jbilander/A500_IDE_LED_board/A500_IDE_LED_board_schematic.pdf

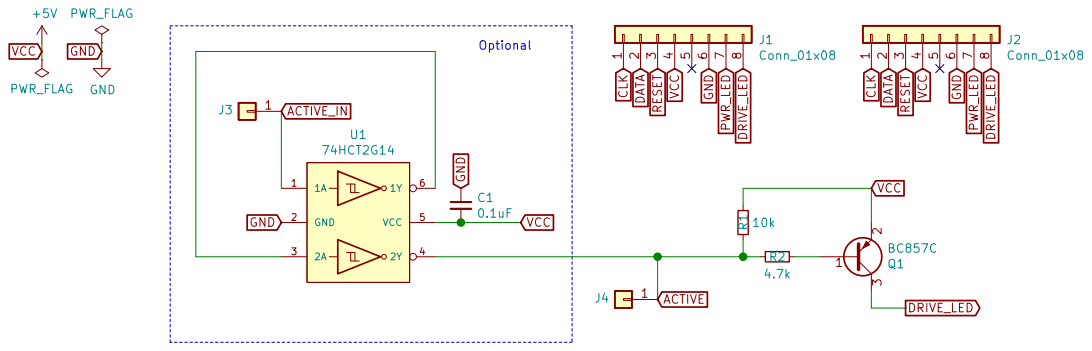
[picture p13: page 1]
