jbilander/A500_IDE_LED_board/KiCad/A500_IDE_LED_board.kicad_pcb

## KiCad design KiCad/A500_IDE_LED_board.kicad_pcb (2022-03-10)

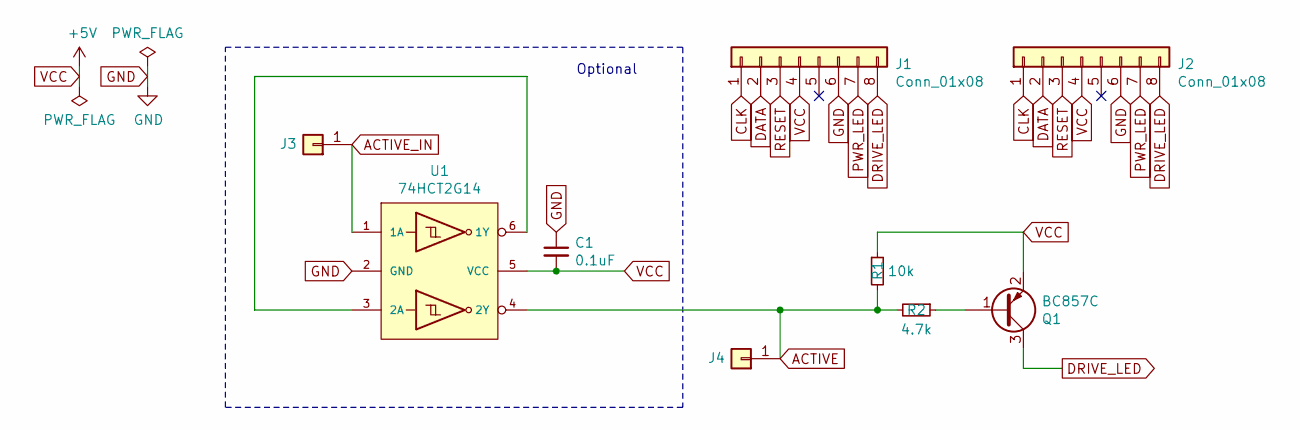
[picture p14: schematic A500_IDE_LED_board.sch]

Parts:
C1: 0.1uF; C_0805_2012Metric_Pad1.15x1.40mm_HandSolder
J1: Conn_01x08; PinHeader_1x08_P2.54mm_Vertical
J2: Conn_01x08; PinSocket_1x08_P2.54mm_Vertical
J3, J4: Conn_01x01; PinHeader_1x01_P2.54mm_Horizontal
Q1: BC857C; SOT-23
R1: 10k; R_1206_3216Metric_Pad1.42x1.75mm_HandSolder
R2: 4.7k; R_1206_3216Metric_Pad1.42x1.75mm_HandSolder
U1: 74HCT2G14; TSOP-6_1.65x3.05mm_P0.95mm

Connections:
ACTIVE: J4.1, R1.2, R2.2, U1.4 (2Y)
ACTIVE_IN: J3.1, U1.1 (1A)
CLK: J1.1, J2.1
DATA: J1.2, J2.2
DRIVE_LED: J1.8, J2.8, Q1.3 (C)
GND: C1.1, J1.6, J2.6, U1.2 (GND)
unnamed: Q1.1 (B), R2.1
unnamed: U1.3 (2A), U1.6 (1Y)
PWR_LED: J1.7, J2.7
RESET: J1.3, J2.3
VCC: C1.2, J1.4, J2.4, Q1.2 (E), R1.1, U1.5 (VCC)

Notes on the sheet:
Optional

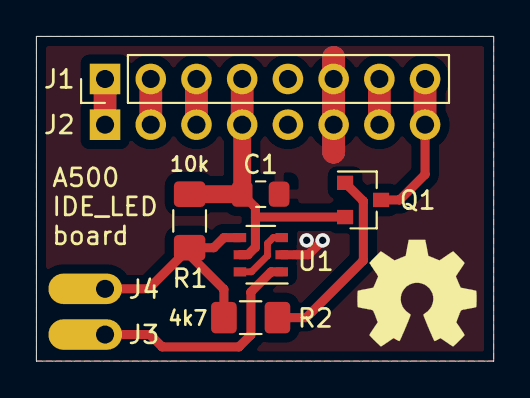
[picture p15: board A500_IDE_LED_board.kicad_pcb from above]

Board: 2 copper layers, 25.4 x 18.0 mm, 9 parts (1 on the bottom side), 11 nets.
