jbilander/A500_IDE_LED_board/(commit log)

2022-03-10 added KiCad files
    [A500_IDE_LED_board.kicad_pcb, A500_IDE_LED_board.sch]
2022-03-10 added schematic pdf
2022-03-10 added output dir
    [A500_IDE_LED_board.kicad_pcb]
2022-03-10 elongated J3-pad, and did some silkscreen fixes
    [A500_IDE_LED_board.kicad_pcb]
2022-03-10 added Revision to silkscreen
    [A500_IDE_LED_board.kicad_pcb]
2022-03-10 re-positioned J4 next to J3 and elongated pad
    [A500_IDE_LED_board.kicad_pcb, A500_IDE_LED_board.sch]
