jbilander/A500_IDE_LED_board/(notices)

Notices in the files:
README.md:
CC BY-SA 4.0
